JoshuaKim1789/KiCad9-Libraries/README.md

# My KiCad 9 Libraries

Last Updated: Dec. 15, 2025

---

```md
KiCad9-Libraries/
├── 3dmodels/
├── footprints/
├── plugins/
├── symbols/
└── template/
```

---
