JoshuaKim1789/KiCad9-Libraries/(commit log)

2025-02-28 Add LED_RED_3216M
2025-03-01 Reference text size 1 mm
2025-03-02 Add a connector L044AFV-02
2025-03-04 Remove duplicated text in a footprint SOIC-8_MCS1806_MNP
2025-03-05 Have fields for BOM accordingly
2025-03-05 Update fields for BOM accordingly
2025-03-06 Rename to LED_SEC-3535
2025-03-06 Refine the symbol LED_SEC_LH351B
2025-03-11 Update the reference name from D to LED for the LED_SEC_LH351B
2025-06-05 Add ESP32-WROOM-32E
2025-06-05 Add PCB footprint and 3D model for SW_Push_SPST_NO_Alps_SKRK
2025-06-08 Add Digikey and LCSC PN to ESP32-WROOM-32E
2025-06-09 Resize the antenna keep-out zone to 18mm (width) x 15mm (height in front of antenna)
2025-06-12 Add an SMD test point of D=1.5mm
2025-06-13 Increase the via drill size from 0.2mm to 0.3mm.
2025-06-14 Increase the circular drill and pad to 0.5mm/0.9mm
2025-06-19 Add a super capacitor: D11.5mm P10mm
2025-06-19 Add a super capacitor: D11.5mm P5.0mm
2025-06-19 Add a symbol 'C_SuperCap_0.33F_5.5V_D11.5mm_P5.0mm'
2025-06-19 Add a supercapacitor symbol C_SuperCap_0.33F_5.5V_D11.5mm_P10.0mm
2025-06-20 Add a Schottky diode symbol SS14
2025-07-13 Update the pad size and position for hand-soldering.
2025-07-24 Add THVD1450 (3.3V RS485 transceiver)
2025-07-28 Add MountingHole_2.7mm_M2.5
2025-07-31 Update 0 ohm
2025-08-08 Add footprints MODULE_SC0193_9 and MODULE_SC0193_9_HAT_RS485X2
2025-08-08 Remove unnecessary 40P holes
2025-08-08 Add stand-offs and screws
2025-08-09 Add a fuse cartridge 2A/250V 3.6x10mm
2025-10-31 Add HANRUN HR911105A Ethernet connector
2025-11-06 Update symbol ESP32-WROOM-32E
